GiacomoAD/Es070-Drone/README.md

# Es070-Drone

Desenvolvimento de um Drone e de seu sistema embarcado com controlador *PID* de velocidade para *Roll* e *Pitch*, controlado remotamente via WiFi. Projeto realizado utilizando o microcontrolador ESP-32.
 
*Projeto final da disciplina ES-070*. 

*Projetado e executado por:*  
Giácomo A. Dollevedo (@GiacomoAD)  
Gustavo Lino Fernandes (@guslifer)

## Documentação

A documentação deste projeto se encontra disponível [neste mesmo repositório](https://github.com/GiacomoAD/Es070-Drone/tree/master/Documentacao).  

Esta documentação inclui todos os códigos para o funcionamento do projeto, bem como os diagramas de *hardware* e *software*.   

Também há um relatório completo contendo a descrição detalhada de todas as etapas de sua execução.

## Vídeos

[Teste do comando *Set Throttle*](https://www.youtube.com/watch?v=9rjGLAiEQOo)

[Teste do cálculo dos ângulos de *Roll* e *Pitch*](https://www.youtube.com/watch?v=8WvH9QH_4Co)

[Teste do Joystick por WiFi](https://www.youtube.com/watch?v=kau0kQcwUB4)

[Teste do controlador de *Roll*](https://www.youtube.com/watch?v=OWnj96heea4)
