GiacomoAD/Es070-Drone/Documentacao/Codigos PDF/DroneWiFi/DroneWiFi_cpp.pdf

/* ***************************************************************** */
/* File name: | DroneWiFi.cpp | */
/* File description: WiFi socket connection handling implementation */
/* Author name: | Giacomo Dollevedo, Gustavo Fernandes | */
/* Creation date: | 18nov2020 | */
/* Revision date: | 07jan2021 | */
/* ***************************************************************** */

#include "DroneWiFi.h"

/*
************************************************************************************ */
/* Method's name: | initWiFi
*/
/* Description: | WiFi initialization. Connects to a network and server.
*/
/* | Authenticates.
*/
/*
*/
/* Entry parameters: | char* ssid -> WiFi network ssid
*/
/* | char* pass -> WiFi network password
*/
/* | char* hostIP -> Server connection IP
*/
/* | int port | -> Server Connection port
*/
/*
*/
/* Return parameters: n/a
*/
/*
************************************************************************************ */
void DroneWiFi::initWiFi(char* ssid, char* pass, char* hostIP, int port)
{

connectWifi(ssid, pass);

unsigned char flag = 0;

while(flag == 0){
flag = connectServer(hostIP, port);
}

if(debugging_enabled){
Serial.println("Connected to Server!"); Serial.println("Sending Authentication..."); }
receiveData();
delay(100);
sendData( "OK\0");
if(debugging_enabled)
Serial.println("\nAuthentication successful!");

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
************************************************************************************ */
/* Method's name: | sendData
*/
/* Description: | WiFi comm. method to send data. Will mark the first 5
bytes */
/* | with the message length for the receiver end.
*/
/*
*/
/* Entry parameters: | WiFiClient _serverCon -> Socket object that represents the
*/
/* | connection
*/
/* | String message -> Message that will be sent through socket
*/
/* | char* len_c -> Array to enable the first 5 bytes marker
*/
/*
*/
/* Return parameters: n/a
*/
/*
************************************************************************************ */
void DroneWiFi::sendData(String message) | // aceita um registro como parâmetro
{
int len = int(message.length());
unsigned int i = 0;

sprintf(_len_marker, "%05d", len); // 5 digits

String envio = _len_marker + message; _serverCon.print(envio);
return;

}

/*
************************************************************************************ */
/* Method's name: | receiveData
*/
/* Description: | WiFi comm. method to receive data. Will read the first 5
*/
/* | incoming bytes and use it to read the incoming stream
*/
/*
*/
/* Entry parameters: | WiFiClient _serverCon -> Socket object that represents the
/* | connection

/* Return parameters: String -> Message read from the connection

************************************************************************************

String DroneWiFi::receiveData()
{
String read_size = "";
int i = 0;
int n;
byte message[249];

while (!_serverCon.available() || _serverCon.available() <= 4) delay(1);
if (_serverCon.available() > 4) {
while (i < 5) {
read_size = read_size + char(_serverCon.read()); i++;
}

n = read_size.toInt();
i = 0;
read_size = "";
}

while (!_serverCon.available() || _serverCon.available() <= (n - 1)) delay(1);

if (_serverCon.available() > 0) {
while (i < n) {
read_size = read_size + char(_serverCon.read()); i++;
}
//Serial.println(read_size); if(debugging_enabled)
Serial.println(read_size); return read_size;
}

}

/*
************************************************************************************ */
/* Method's name: | setParams
*/
/* Description: | Set internal droneParams variable
*/
/*
*/
/* Entry parameters: | droneParams prm -> struct to be set
*/
/*
*/
/* Return parameters: n/a

************************************************************************************

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
124 void DroneWiFi::setParams(droneParams prm) {

_params = prm;
return;

}

/*
************************************************************************************ */
/* Method's name: | getParams
*/
/* Description: | Return the internal drone parameters struct
*/
/*
*/
/* Entry parameters: | n/a
*/
/*
*/
/* Return parameters: droneParams -> internal parameters struct
*/
/*
************************************************************************************ */
droneParams DroneWiFi::getParams()
{
return _params;
}

/*
************************************************************************************ */
/* Method's name: | getPIDGains
*/
/* Description: | Return the internal drone PID gains to specific axis
*/
/*
*/
/* Entry parameters: | unsigned char axis -> desired axis gains
*/
/*
*/
/* Return parameters: pidGains -> internal PID gains struct
*/
/*
************************************************************************************ */
pidGains DroneWiFi::getPIDGains(unsigned char axis)
{
if(axis == 'r'){
return _pidRoll;

else if(axis == 'p'){

return _pidPitch;

else
return _pidYaw;
}

/*
************************************************************************************ */
/* Method's name: | connectWifi
*/
/* Description: | Attempts wifi network connection
*/
/*
*/
/* Entry parameters: | char* ssid -> Network SSID (name)
*/
/* | char* pass -> Network password
*/
/*
*/
/* Return parameters: unsigned char -> 0 == failed to connect / 1 == success */
/*
************************************************************************************ */
unsigned char DroneWiFi::connectWifi(char* ssid, char* pass)
{
_wifiCon.addAP(ssid, pass); // Network name and password

if(debugging_enabled){
Serial.println();
Serial.println();
Serial.print("Waiting for WiFi... "); }
while (_wifiCon.run() != WL_CONNECTED) { if(debugging_enabled)
Serial.print(".");
delay(500);
}

if(debugging_enabled)
Serial.println("\nConnected to WiFi!");

return 1;

}

/*
************************************************************************************ */
/* Method's name: | connectServer
/* Description: | Attempts server connection through WiFi network

/* Entry parameters: | char* hostIP -> Server connection IP
/* | int port | -> Server Connection port
*/
/*
*/
/* Return parameters: unsigned char -> 0 == failed to connect / 1 == success */
/*
************************************************************************************ */
unsigned char DroneWiFi::connectServer(char* hostIP, int port)
{
if (!_serverCon.connect(hostIP, port)) { if(debugging_enabled){
Serial.println("Connection failed."); Serial.println("Waiting 5 seconds before retrying..."); }
delay(5000);
return 0;
}

else{
return 1;
}
}

/*
************************************************************************************ */
/* Method's name: | processComm
*/
/* Description: | State machine to process server communication commands
*/
/*
*/
/* Entry parameters: | String msg -> server command to be handled
*/
/*
*/
/* Return parameters: n/a
*/
/*
************************************************************************************ */
void DroneWiFi::processComm(String msg)
{
| int len = (int)msg.length();
int i = 0;
unsigned char j = 0;
| unsigned char k_flag = 1;
char ch;
char buffer_k[10];

/*Se o Joystick esta habilitado, a maquina de estados eh diferente*/ if(joystick_enabled){
switch (msg[0]){

/*Caso 's' sai do modo de Joystick*/ case 's':
joystick_enabled = 0;
if(debugging_enabled)
Serial.println("Joystick Disabled."); break;

/*Caso '5' reseta os setpoints de velocidade*/ case '5':
_joystickSetpoints.roll = 0; _joystickSetpoints.pitch = 0;
break;

/*Caso '8' diminui velocidade de pitch*/ case '8':
_joystickSetpoints.pitch -= VEL_INC; if(_joystickSetpoints.pitch <= -10) _joystickSetpoints.pitch = -10;

break;

/*Caso '2' aumenta velocidade de pitch*/ case '2':
_joystickSetpoints.pitch += VEL_INC; if(_joystickSetpoints.pitch >= 10) _joystickSetpoints.pitch = 10; break;

/*Caso '8' aumenta velocidade de roll*/ case '6':
_joystickSetpoints.roll += VEL_INC; if(_joystickSetpoints.roll >= 10) _joystickSetpoints.roll = 10;

break;

/*Caso '8' diminui velocidade de roll*/ case '4':
_joystickSetpoints.roll -= VEL_INC; if(_joystickSetpoints.roll <= -10) _joystickSetpoints.roll = -10;
break;

/*Caso '+' aumenta potencia base dos motores*/ case '+':
_joystickSetpoints.throttle += VEL_INC; if(_joystickSetpoints.throttle >= 50) _joystickSetpoints.throttle = 50;
break;

/*Caso '-' diminui potencia base dos motores*/ case '-':
_joystickSetpoints.throttle -= VEL_INC; if(_joystickSetpoints.throttle <= 0) _joystickSetpoints.throttle = 0; break;

case '#':

break;

default:
if(debugging_enabled)
Serial.println("Unindentified Command."); break;
}

}

else{
while(i < len){
ch = msg[i];
switch(ch){
case '#':
i++;
break;
case 'K':
i++;
break;
case 'S':
i++;
break;
//#ST1000;1000;1000;1000

case 'T':
/*Checa se o comando foi do tipo "Set"*/
if(msg[i-1] == 'S')
if(len == 22){
_params.M1 = (msg[3]-48)*1000 + (msg[4]-48)*100 + (msg[5]-48)*10 + (msg[6]-48);
_params.M2 = (msg[8]-48)*1000 + (msg[9]-48)*100 + (msg[10]-48)*10 + (msg[11]-48);
_params.M3 = (msg[13]-48)*1000 + (msg[14]-48)*100 + (msg[15]-48)*10 + (msg[16]-48);
_params.M4 = (msg[18]-48)*1000 + (msg[19]-48)*100 + (msg[20]-48)*10 + (msg[21]-48);
}
i = len;
break;

case 'G':
/*Checa se o comando foi apenas o "GO" do sistema*/ if(msg[i-1]== '#'){
if(debugging_enabled)
Serial.println("Main Loop Started!"); sendData("Ready to fly!\0");
}

/*Checa se o comando foi do tipo "Set"*/ //#SGaxis;kp;ki;kd
if(msg[i-1] == 'S'){
i++;
/*Caso o eixo escolhido tenha sido Roll*/ if(msg[i] == 'r'){
i = i + 2;

while(i < len){
buffer_k[j] = msg[i];
i++;
j++;

if(msg[i] == ';'){
buffer_k[j] = '\0';
Serial.println(buffer_k);

if(k_flag == 1){
_pidRoll.kp = atof(buffer_k); Serial.println(_pidRoll.kp); k_flag++;
}

else if(k_flag == 2){
_pidRoll.ki = atof(buffer_k); Serial.println(_pidRoll.kp); k_flag++;
}

j = 0;
i++;
}
}

buffer_k[j] = '\0';
Serial.println(buffer_k);

_pidRoll.kd = atof(buffer_k); Serial.println(_pidRoll.kd); k_flag = 1;

}
/*Caso o eixo escolhido tenha sido Pitch*/ else if(msg[i] == 'p'){
i = i + 2;

while(i < len){
buffer_k[j] = msg[i];
i++;
j++;

if(msg[i] == ';'){
buffer_k[j] = '\0';

if(k_flag == 1){
_pidPitch.kp = atof(buffer_k); k_flag++;
}

else if(k_flag == 2){
_pidPitch.ki = atof(buffer_k); k_flag++;

j = 0;
i++;

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
buffer_k[j] = '\0';
_pidPitch.kd = atof(buffer_k); k_flag = 1;
}

/*Qualquer outro caso, cai no Yaw*/ else{
i = i + 2;

while(i < len){
buffer_k[j] = msg[i];
i++;
j++;

if(msg[i] == ';'){
buffer_k[j] = '\0';

if(k_flag == 1){
_pidYaw.kp = atof(buffer_k); k_flag++;
}
else if(k_flag == 2){
_pidYaw.ki = atof(buffer_k); k_flag++;
}

j = 0;
i++;
}
}

buffer_k[j] = '\0';
_pidYaw.kd = atof(buffer_k); k_flag = 1;
}

}
i++;
break;

/*NAO COMPLETO!*/
/*Alteracao de velocidade*/ /*NAO COMPLETO!*/
case 'V':
/*NAO COMPLETO!*/
/*if(len == 7){
_params.setPoint = (msg[3]-48)*10 + (msg[4]-48); _params.time = (msg[6]-48);
}

i = len;*/
break;

/*Comando para resetar a potencia dos motores*/ case 'R':

_params.M1 = 1200;

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
_params.M2 = 1200;
_params.M3 = 1200;
_params.M4 = 1200;

i = len;
break;

/*Comando para Habilitar Joystick*/ case 'J':
joystick_enabled = 1;
i++;
if(debugging_enabled)
Serial.println("Joystick Enabled."); break;

/*Comandos que nao foram identificados*/ default:
if(debugging_enabled)
Serial.println("Unindentified Command."); i = len;
}
}
}

return;
}

/*
************************************************************************************ */
/* Method's name: | getVel
*/
/* Description: | Return the internal joystick setpoints struct
*/
/*
*/
/* Entry parameters: | n/a
*/
/*
*/
/* Return parameters: rotVel -> internal joystick setpoints struct
*/
/*
************************************************************************************ */
rotVel DroneWiFi::getVel(){
return _joystickSetpoints;
}

/*
************************************************************************************ */
/* Method's name: | enableDebug
*/
/* Description: | Enables Serial Comm Printing

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
/* Entry parameters: | n/a
/* Return parameters: | n/a
*/
/*
************************************************************************************ */
void DroneWiFi::enableDebug(){
debugging_enabled = 1;
}

/*
************************************************************************************ */
/* Method's name: | disableDebug
*/
/* Description: | Disables Serial Comm Printing
*/
/*
*/
/* Entry parameters: | n/a
*/
/*
*/
/* Return parameters: n/a
*/
/*
************************************************************************************ */
void DroneWiFi::disableDebug(){
debugging_enabled = 0;
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
