GiacomoAD/Es070-Drone/Documentacao/Codigos PDF/Server/Server_py.pdf

# -*- coding: utf-8 -*-

# File name: | server.py

# File description: Socket server for EH-Drone control

# Author name: Giacomo Dollevedo, Gustavo Fernandes #

# Creation date: 18nov2020

# Revision date: 17dec2020

from threading import Thread
import socket
from queue import PriorityQueue import curses

global svDisp
global svInput
global blank
blank = " | "

cmd_q = PriorityQueue(maxsize = 5)

global droneOnline
droneOnline = 0

global recv_counter
recv_counter = 0
# | Method Name: receive

# | Description: This method is used to receive text data from a socket connection,

without decoding from bytes to text #
# | Input parameters: | conn -> Socket object that data will be received from

# | Output parameters: Returns the message in byte format

def receive(conn):
| try:

message_len = int(conn.recv(5).decode()) #Receiving first 5 bytes (incoming message length)
return conn.recv(message_len) | #Returning the incoming message

except socket.error as e:
print(e)
pass
# | Method Name: sendD

# | Description: This method is used to send text data over a socket connection,

enconding it into bytes and | #
# | marking the first 5 bytes with the message length.

# | Input parameters: | conn -> Socket object that data will be sent to

# | | data -> String that will be sent over the connection

# | Output parameters: n/a

def sendD(conn, data):
| try:
data_b = str.encode(data)
data_len = str(len(data_b))

code = str.encode(data_len.rjust(5, '0')) #Making a 5 byte sized string with '0's
message = code + data_b | #Concatenating length and message
conn.sendall(message) | #Sending resulting message

except socket.error as e:
| print(e)
| pass

# Method Name: authESP

# | Description: Authentication routine to ensure the client that was connected is

the Drone client | #
# | Input parameters: | conn -> Socket object that data will be sent to #

# | Output parameters: n/a

def authESP(conn):
| global svDisp

sendD(conn, "#AEHDRONE")

print("Autenticando...")
svDisp.addstr(4,0,'Autenticando...')
| svDisp.refresh()
key = receive(conn).decode()
| if(key == "OK"): return 1
| else: return 0
# Method Name: threadedHandleDrone #

# Description: Threaded method that will handle all Drone socket communication #

# | Input parameters: | conn -> Socket object that data will be sent to

# | Output parameters: n/a

def threadedHandleDrone(conn):
| global droneOnline
| global recv_counter

global svDisp
global svInput
global blank

command = "NULL"

with conn:
while(command != "#G"):
try:
command = cmd_q.get()[1]

except:
command = "NULL"

print("ENVIANDO --->\t" + command) svDisp.addstr(7,0,'ENVIANDO COMANDO --->') svDisp.addstr(7,23, command) svDisp.refresh()
svInput.refresh()

sendD(conn, command)

msg = receive(conn).decode(encoding="utf-8") print("RECEBIDO --->\t" + msg) svDisp.addstr(8,0,'MENSAGEM RECEBIDA --->')

svDisp.addstr(8,24, str(msg))

svDisp.refresh()

svInput.addstr(3,0,"JOYSTICK DESABILITADO", curses.color_pair(3)|curses.A_BOLD) svInput.addstr(4,0,"\t´#J´ = HABILITAR JOYSTICK", curses.color_pair(1)) svInput.addstr(5,0,"\t´#SGaxis;kp;ki;kd´ = SETAR GANHO CONTROLADOR POR EIXO", curses.color_pair(2))
svInput.addstr(6,0,"\t´SVxxxx;xxxx;xxxx;xxxx´ = SETAR THROTTLE", curses.color_pair(1))
svInput.addstr(7,0,"\t´#R´ = RESETAR MOTORES PARA VELOCIDADE BASE", curses.color_pair(2))
svInput.clrtobot()
svInput.move(1,15)
svInput.refresh()

while(droneOnline == 1):

if(cmd_q.qsize() == 0):
try:
cmd_q.put((3, "#K"))
except:
pass
else:
pass

print("AGUARDANDO...")
msg = receive(conn).decode(encoding="utf-8") print("RECEBIDO --->\t" + msg) svDisp.addstr(8,0,'MENSAGEM RECEBIDA --->')

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
171 splitado = str(msg).split("\n")

try:
svDisp.addstr(8,24, splitado[0]) svDisp.addstr(9,24, splitado[1])

except:
pass

#svDisp.addstr(8,24, str(msg) + blank) svDisp.refresh()

svInput.refresh()
recv_counter += 1

if(recv_counter == 5):
command = cmd_q.get()[1]

# if(command == '#J'):

# curses.cbreak()

# if(command == 's'):

# curses.nocbreak()

print("ENVIANDO --->\t" + command) svDisp.addstr(7,0,'ENVIANDO COMANDO --->') #svDisp.move(7,23)
#svDisp.clrtoel()

svDisp.addstr(7,23, command + blank) svDisp.refresh()
svInput.refresh()
sendD(conn, command)
recv_counter = 0
# | Method Name: main

# | Description: Main method that the script runs. Start up the server and handle

user input. | #
# | Input parameters: | stdscr -> Curses library object to better handle console

display | #
# | Output parameters: n/a

def main(stdscr):

global droneOnline
global svDisp
global svInput
global blank

#HOST = '192.168.43...'

HOST = '192.168.43.182'
PORT = 25565 | # Port to listen on (non-privileged ports are > 1023)

joystick_enabled = 0

##%% SERVER CREATION AND CONNECTION SECTION

# Statement to ensure this will run only once and will not create infinite # instances recursively (Python error)

if __name__ == '__main__': #OOOOOOOOOOOOOOOOOOOOOOOOOOOOOOOOOOOOOOOOOOOOOOOOOO curses.nocbreak()
svDisp = curses.newwin(20,120,0,0)

svInput = curses.newwin(8,120,21,0)
curses.start_color()
curses.init_pair(1, curses.COLOR_GREEN, curses.COLOR_BLACK) curses.init_pair(2, curses.COLOR_YELLOW, curses.COLOR_BLACK) curses.init_pair(3, curses.COLOR_RED, curses.COLOR_BLACK) curses.init_pair(4, curses.COLOR_GREEN, curses.COLOR_WHITE)

curses.echo()
svInput.keypad(True)

svInput.addstr(0,0, "------------------------------------------------------------------------------------------------------------------------") svInput.addstr(1,0, "User Input >>")
svInput.addstr(2,0, "------------------------------------------------------------------------------------------------------------------------") svInput.move(1,15)
svInput.refresh()

# Creating a socket object

# AF_INET -> IPv4 address

# SOCK_STREAM -> TCP Connection

s = socket.socket(socket.AF_INET, socket.SOCK_STREAM)

# Binding socket object to a specific host (IP) and network port try:

s.bind((HOST, PORT))
except socket.error as e:
print(e)

# Starting the server by listening to incoming connections s.listen()

print('------SERVER STARTED------') svDisp.addstr(0,0,'------SERVER STARTED------') svDisp.refresh()

while True:
# When connection is found, store its socket object (conn) and address print('Listening to connections...\n')

svDisp.addstr(2,0,'Listening to connections...')
svDisp.refresh()
try:
conn, addr = s.accept()
print(conn)
print(addr)
svDisp.addstr(3,0,"Cliente Conectado: " + str(addr)) svDisp.refresh()

if(authESP(conn)):
print('Autenticado!')
svDisp.addstr(5,0,'Autenticado!')
svDisp.refresh()
svInput.refresh()
client_thread = Thread(target=threadedHandleDrone, args=(conn,)) client_thread.daemon = True
client_thread.start()
droneOnline = 1

while(droneOnline == 1):

if(joystick_enabled == 0):
command = svInput.getstr().decode(encoding="utf-8")

else:
command = svInput.getkey()

if(command == 'PADPLUS'):
command = '+'

elif(command == 'PADMINUS'): command = '-'

cmd_q.put((1, command))

if(command == '#J'):
joystick_enabled = 1
curses.cbreak()
svInput.move(3,0)
svInput.clrtobot()
svInput.addstr(3,0,"JOYSTICK HABILITADO", curses.color_pair(1)|curses.A_BOLD) svInput.addstr(4,0,"\t´8´ = -PITCH RATE\t ´4´ = -ROLL RATE\t ´-´ = -THROTTLE", curses.color_pair(1)) svInput.addstr(5,0,"\t´2´ = +PITCH RATE\t ´6´ = +ROLL RATE\t ´+´ = +THROTTLE", curses.color_pair(1))

svInput.addstr(6,0,"\t´5´ = SETAR ROLL E PITCH PARA 0", curses.color_pair(2))
svInput.addstr(7,0,"\t´s´ = DESABILITAR JOYSTICK", curses.color_pair(3))
svInput.addstr(3,99, "8",
curses.color_pair(1)|curses.A_BOLD) svInput.addstr(4,99, "|",
curses.color_pair(1)|curses.A_BOLD) svInput.addstr(5,95, "4---5---6", curses.color_pair(1)|curses.A_BOLD) svInput.addstr(6,99, "|",
curses.color_pair(1)|curses.A_BOLD) svInput.addstr(7,99, "2",
curses.color_pair(1)|curses.A_BOLD)

if(command == 's'):
joystick_enabled = 0
svInput.move(3,0)
svInput.clrtobot()
svInput.addstr(3,0,"JOYSTICK DESABILITADO", curses.color_pair(3)|curses.A_BOLD) svInput.addstr(4,0,"\t´#J´ = HABILITAR JOYSTICK", curses.color_pair(1))
svInput.addstr(5,0,"\t´#SGaxis;kp;ki;kd´ = SETAR GANHO CONTROLADOR POR EIXO", curses.color_pair(2)) svInput.addstr(6,0,"\t´STxxxx;xxxx;xxxx;xxxx´ = SETAR THROTTLE", curses.color_pair(1)) svInput.addstr(7,0,"\t´#R´ = RESETAR MOTORES PARA VELOCIDADE BASE", curses.color_pair(2)) svInput.refresh()
curses.nocbreak()

svDisp.addstr(10,0, "ULTIMO COMANDO INSERIDO --->" + command + blank)
svDisp.refresh()

svInput.move(1,15)
svInput.clrtoeol()
svInput.refresh()

else:
print('ERRO na Autenticacao!\nEncerrando o programa!') break

except (KeyboardInterrupt, SystemExit, socket.error): s.close()
print('Server Closed')

s.close()
print('Server closed')

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
return

curses.wrapper(main)

main()

389
390
391
392
