GiacomoAD/Es070-Drone/Documentacao/Codigos PDF/ThrottleControl/ThrottleControl_cpp.pdf

/************************************************************************
* Descrição: Arquivo c++ que implementa a interface de controle | *
* de velocidade dos motores do Drone | *
* Autores: Gustavo L. Fernandes e Giácomo A. Dollevedo | *
* Ultima Atualização: 03/01/2021 | *
*************************************************************************/ #include "ThrottleControl.h"

/* ******************************************************************************** */
/* Nome do metodo: | ThrottleControl
*/
/* Descrição: | Método construtor do objeto, não faz nada além de
*/
/* | associar 4 objetos do tipo Servo que serão utilizados
*/
/*
*/
/* Parametros de entrada: Nenhum (Vazio) */
/*
*/
/* Parametros de saida: Nenhum (Vazio) */
/*
*/
/*
*/
/* ******************************************************************************** */
ThrottleControl::ThrottleControl()
{
Serial.println("Objeto de Drone Criado!");
_actualVel = (int*) calloc(3, sizeof(int));
}

/* ******************************************************************************** */
/* Nome do metodo: | initializeMotors
*/
/* Descrição: | Inicia cada um dos motores criados, atrelando a uma
saída*/
/* | PWM do ESP32 e setando os limites max e min que define
*/
/* | também a inicialização dos 4 ESC
*/
/*
*/
/* Parametros de entrada: int pinMotor1, int pinMotor2, int pinMotor3, int pinMotor4*/
/* | Pinos PWM que serão conectados os sinais de controle
*/
/* Parametros de saida: Nenhum (Vazio)
*/
/*

/* ********************************************************************************

void ThrottleControl::initializeMotors(int pinMotor1, int pinMotor2, int pinMotor3, int pinMotor4)
{

_m1.attach(pinMotor1,1000, 2000);
_m2.attach(pinMotor2,1000, 2000); _m3.attach(pinMotor3,1000, 2000); _m4.attach(pinMotor4,1000, 2000);

_m1.write(1000);
_m2.write(1000);

_m3.write(1000);
_m4.write(1000);

delay(2000);

}

/* ******************************************************************************** */
/* Nome do metodo: | setActualVel
*/
/* Descrição: | Define as velocidades que serão atingidas pelos 4
motores*/
/*
*/
/*
*/
/* Parametros de entrada: int desiredVel1, int desiredVel2, int desiredVel3, */
/* | int desiredVel4 , que são as velocidades desejadas
*/
/* | aceita valores entre 1000 e 2000 mas limita em 1500
*/
/* Parametros de saida: Nenhum (Vazio)
*/
/*
*/
/*
*/
/* ******************************************************************************** */

void ThrottleControl::setActualVel(int desiredVel1, int desiredVel2, int desiredVel3, int desiredVel4)
{
// if((desiredVel1 < 1500) & (desiredVel2 < 1500) & (desiredVel3 < 1500) & (desiredVel4 < 1500)){
_m1.write(desiredVel1);
_m2.write(desiredVel2);
_m3.write(desiredVel3);
_m4.write(desiredVel4);

// }
}

/* ********************************************************************************

/* Nome do metodo: | getActualVel
*/
/* Descrição: | Consulta o sinal pwm definido nos 4 motores
*/
/*
*/
/*
*/
/* Parametros de entrada: Nenhum (Vazio) */
/*
*/
/* Parametros de saida: int* array com os 4 valores de velocidades lidos */
/*
*/
/*
*/
/* ******************************************************************************** */

int* ThrottleControl::getActualVel(){

_actualVel[0] = 1000 + (5.555* _m1.read()); _actualVel[1] = 1000 + (5.555* _m2.read()); _actualVel[2] = 1000 + (5.555* _m3.read()); _actualVel[3] = 1000 + (5.555* _m4.read());

return _actualVel;
}

/* ******************************************************************************** */
/* Nome do metodo: | gtestMotors
*/
/* Descrição: | Testa se os motores estão funcinoando e respondendo
*/
/*
*/
/*
*/
/* Parametros de entrada: Nenhum (Vazio) */
/*
*/
/* Parametros de saida: boolean (1 Funcionando) (0 Com problemas) */
/*

/* ********************************************************************************

void ThrottleControl:: testMotors(){ _m1.write(1500);
delay(5000);
_m1.write(1000);

_m2.write(1500);
delay(5000);
_m2.write(1000);

_m3.write(1500);
delay(5000);
_m3.write(1000);

_m4.write(1500);
delay(5000);
_m4.write(1000);
}

/* ******************************************************************************** */
/* Nome do metodo: | Control
*/
/* Descrição: | Distribuia a velocidade controlada para os 4 motores
*/
/*
*/
/*
*/
/* Parametros de entrada: FlightControl pidRoll, FlightControl pidPitch, */
/* | FlightControl pidYaw , que são os objetos
*/
/* | do controlador implementado para cada eixo
*/
/*
*/
/* Parametros de saida: Vazio (Nenhum) */
/*
*/
/*
*/
/* ******************************************************************************** */

void ThrottleControl::Control(FlightControl pidRoll, FlightControl pidPitch,FlightControl pidYaw, float rollVel, float pitchVel, float yawVel){

//Executa a atualização do sinal de controle de cada um dos eixos

pidRoll.pidVelControl(rollVel);
pidPitch.pidVelControl(pitchVel);
pidYaw.pidVelControl(yawVel);
int desiredVel1, desiredVel2, desiredVel3, desiredVel4;

//Calcula as compensações em cada motor para manter o controle de cada um dos eixos de movimentação
desiredVel1 = _throttle - pidPitch.getPID_Calculated() -pidRoll.getPID_Calculated() - pidYaw.getPID_Calculated();
desiredVel2 = _throttle - pidPitch.getPID_Calculated() + pidRoll.getPID_Calculated() + pidYaw.getPID_Calculated() ; desiredVel3 = (_throttle +30) + pidPitch.getPID_Calculated() -pidRoll.getPID_Calculated() + pidYaw.getPID_Calculated(); desiredVel4 = _throttle + pidPitch.getPID_Calculated() + pidRoll.getPID_Calculated() - pidYaw.getPID_Calculated();

//Vamos saturar as velocidades maximas em cada motor if(desiredVel1 > MAXTHROTTLE){
desiredVel1 = MAXTHROTTLE;
}
if(desiredVel2 > MAXTHROTTLE){ desiredVel2 = MAXTHROTTLE; }
if(desiredVel3 > MAXTHROTTLE){ desiredVel3 = MAXTHROTTLE; }
if(desiredVel4 > MAXTHROTTLE){
desiredVel4 = MAXTHROTTLE;
}

//Seta a nova velocidade necessária para manter a saida controlada setActualVel(desiredVel1, desiredVel2, desiredVel3, desiredVel4);

}

/* ******************************************************************************** */
/* Nome do metodo: | SingleAxisVelControl
*/
/* Descrição: | Distribui a velocidade controlada para os 2 motores
*/
/* | de modo a contrlar apenas um eixo de movimento
*/
/*
*/
/* Parametros de entrada: FlightControl pidPitch que é objeto do eixo pitch de */
/* | controle | ,
*/
/*
*/
/*
*/
/* Parametros de saida: Vazio (Nenhum) */
/*
*/
/*
*/
/* ********************************************************************************

void ThrottleControl::SingleAxisVelPitchControl(FlightControl pidPitch){
| int desiredVel1, desiredVel2;

//Calcula as compensações em cada motor para manter o controle de apenas um dos eixos de movimentação (pitch)
desiredVel1 = _throttle - pidPitch.getPID_Calculated() ;
desiredVel2 = _throttle + pidPitch.getPID_Calculated() ;

//Vamos saturar as velocidades maximas em cada motor if(desiredVel1 > MAXTHROTTLE){
desiredVel1 = MAXTHROTTLE;
}
if(desiredVel2 > MAXTHROTTLE){ desiredVel2 = MAXTHROTTLE;
}

//Seta a nova velocidade necessária para manter a saida controlada setActualVel(desiredVel1, desiredVel2 ,1000, 1000 );
}

/* ******************************************************************************** */
/* Nome do metodo: | SingleAxisVelControl
*/
/* Descrição: | Distribui a velocidade controlada para os 2 motores
*/
/* | de modo a contrlar apenas um eixo de movimento
*/
/*
*/
/* Parametros de entrada: FlightControl pidRoll que é objeto do eixo roll de */
/* | controle | ,
*/
/*
*/
/*
*/
/* Parametros de saida: Vazio (Nenhum) */
/*
*/
/*
*/
/* ******************************************************************************** */

void ThrottleControl::SingleAxisVelRollControl(FlightControl pidRoll){
| int desiredVel1, desiredVel2;

//Calcula as compensações em cada motor para manter o controle de apenas um dos eixos de movimentação (Roll)
desiredVel1 = _throttle - pidRoll.getPID_Calculated() ;
desiredVel2 = _throttle + pidRoll.getPID_Calculated() ;

//Vamos saturar as velocidades maximas em cada motor
| if(desiredVel1 > MAXTHROTTLE){

desiredVel1 = MAXTHROTTLE; }
if(desiredVel2 > MAXTHROTTLE){ desiredVel2 = MAXTHROTTLE;
}

//Seta a nova velocidade necessária para manter a saida controlada setActualVel(desiredVel1, desiredVel2 ,1000, 1000 );
}

/* ******************************************************************************** */
/* Nome do metodo: | getThrottle
*/
/* Descrição: | Consulta a velocidade (pwm) base atual dos motores
*/
/*
*/
/*
*/
/* Parametros de entrada: Vazio (Nenhum) */
/*
*/
/*
*/
/*
*/
/* Parametros de saida: _throttle (int) */
/*
*/
/*
*/
/* ******************************************************************************** */
int ThrottleControl::getThrottle(){
return _throttle;
}

/* ******************************************************************************** */
/* Nome do metodo: | setThrottle
*/
/* Descrição: | Define nova velocidade (pwm) base atual dos motores
*/
/*
*/
/*

/* Parametros de entrada: throttleDesired (int)

/* Parametros de saida: Vazio (Nenhum ) */
/*
*/
/*
*/
/* ******************************************************************************** */
void ThrottleControl::setThrottle(int throttleDesired){
_throttle = throttleDesired;
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
