GiacomoAD/Es070-Drone/Documentacao/Diagramas/Fluxograma_loop.png

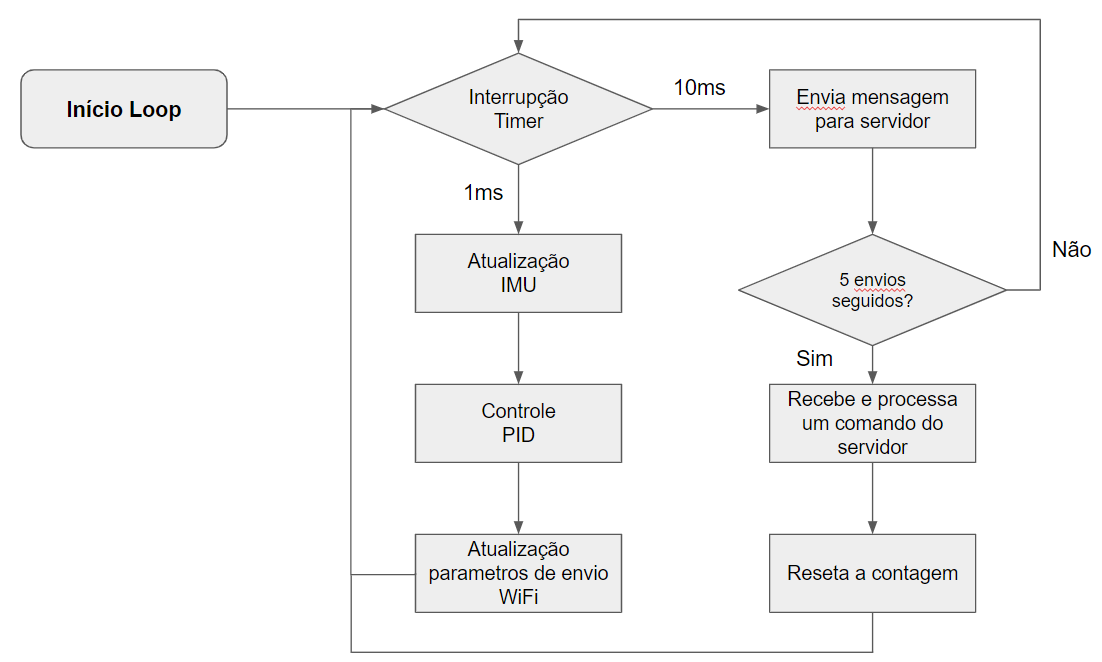
Documentacao/Diagramas/Fluxograma_loop.png
