GiacomoAD/Es070-Drone/Documentacao/Diagramas/Fluxograma_setup.png

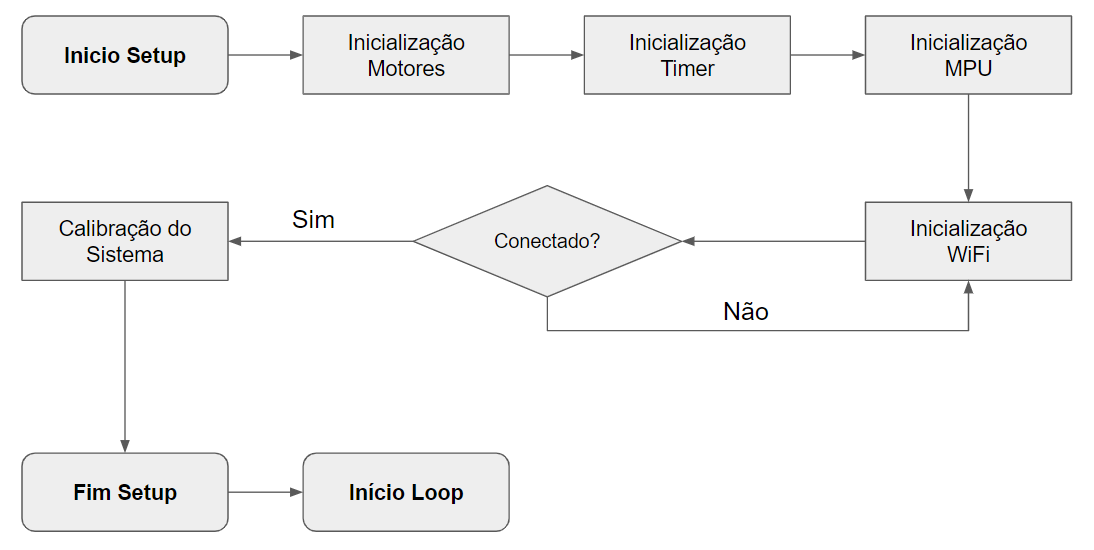
Documentacao/Diagramas/Fluxograma_setup.png
