GiacomoAD/Es070-Drone/(commit log)

2020-11-14 Interface ESC
    Biblioteca que implementa a interface do ESC para manipular os motores
2021-01-12 Mudança de comentario na main
